jancelin/rover-gnss/Rover-RTK_ESP32/README.md

# CentipedeRTK rover-gnss

Documentation of rover-gnss

## Config ARDUINO

Ajouter le catalogue de carte ESP32 https://raw.githubusercontent.com/espressif/arduino-esp32/gh-pages/package_esp32_index.json
Configurer le chemin du répertoire en local à la racine duquel se trouve le répertoire "libraries"
File > Preference


### Probleme possible

Driver Windows => Installer le driver

Ubuntu - Ajouter le compte utilisateur au groupe serial
