jancelin/rover-gnss/conf_GNSS/UM98X/README.md

# CONFIGURATION UM980

* Avec le navigateur Chrome ou Edge ouvrir la page https://webserial.centipede.fr/index_advanced.html
* connecter en USB le ROVER
* cliquer sur *Connecter*
* Choisir le ficheir de configuration *Navx GNSS Town*
* cliquer sur *Envoyer*
