jancelin/rover-gnss/Rover-RTK_Bluetooth/DIY/pictures/feasycom-BT836_back.png

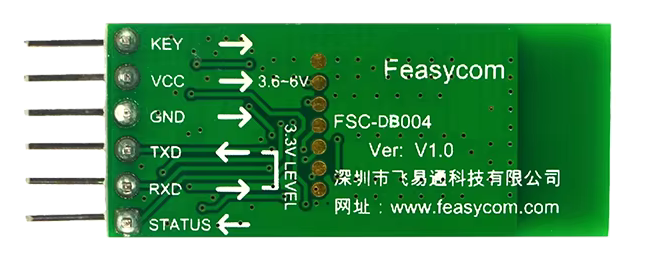
Rover-RTK_Bluetooth/DIY/pictures/feasycom-BT836_back.png
