jancelin/rover-gnss/Rover-RTK_Bluetooth/DIY/pictures/feasycom-BT836_top.png

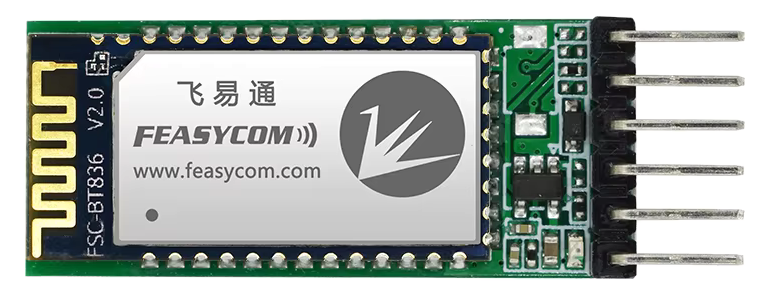
Rover-RTK_Bluetooth/DIY/pictures/feasycom-BT836_top.png
