jancelin/rover-gnss/Rover-RTK_Bluetooth/DIY/pictures/li-ion.png

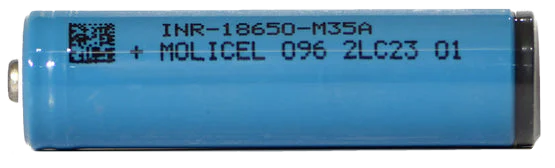
Rover-RTK_Bluetooth/DIY/pictures/li-ion.png
