jancelin/rover-gnss/Rover-RTK_Bluetooth/DIY/pictures/push_button.png

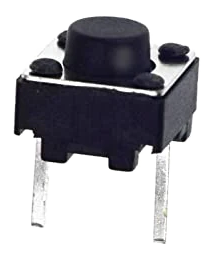
Rover-RTK_Bluetooth/DIY/pictures/push_button.png
