jancelin/rover-gnss/Rover-RTK_Bluetooth/DIY/pictures/single-battery1.png

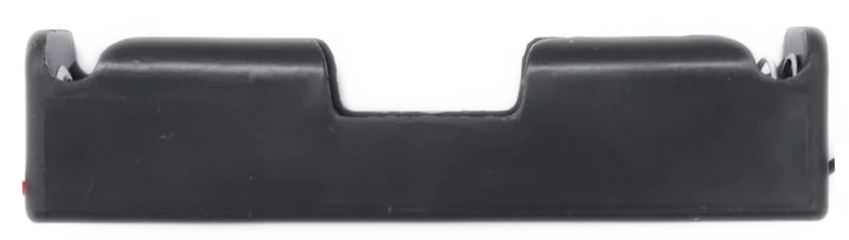
Rover-RTK_Bluetooth/DIY/pictures/single-battery1.png
