jancelin/rover-gnss/Rover-RTK_Bluetooth/DIY/pictures/um980.png

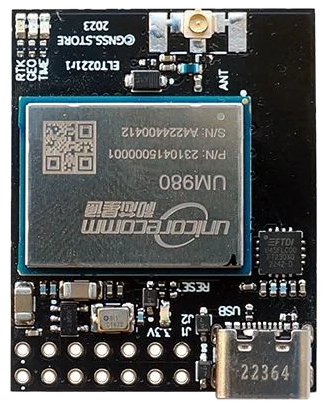
Rover-RTK_Bluetooth/DIY/pictures/um980.png
