jancelin/rover-gnss/Rover-RTK_Bluetooth/DIY/pictures/um980.webp

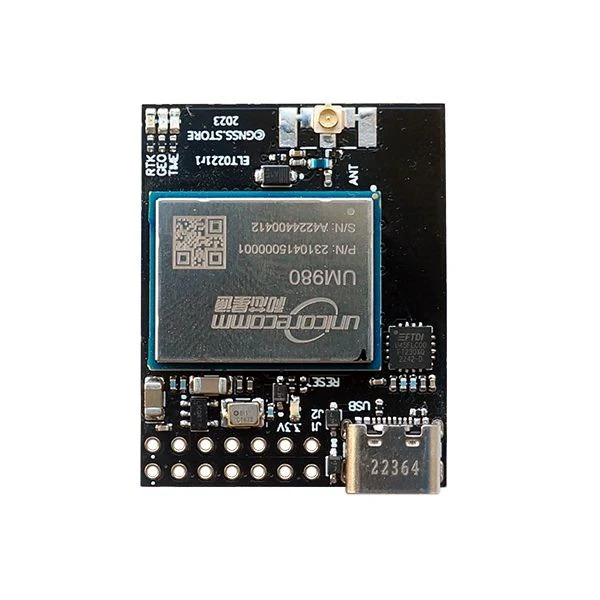
Rover-RTK_Bluetooth/DIY/pictures/um980.webp
