jancelin/rover-gnss/Rover-RTK_Bluetooth/DIY/pictures/usb_femelle.png

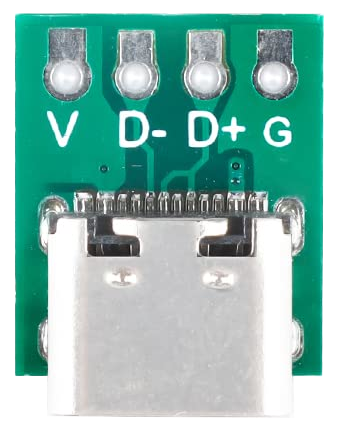
Rover-RTK_Bluetooth/DIY/pictures/usb_femelle.png
