jancelin/rover-gnss/Rover-RTK_Bluetooth/DIY/pictures/usb_male.png

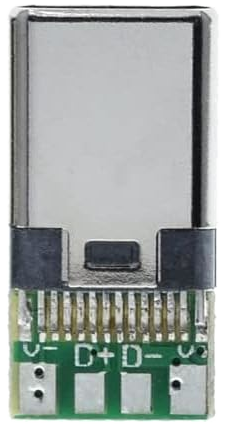
Rover-RTK_Bluetooth/DIY/pictures/usb_male.png
