jancelin/rover-gnss/Rover-RTK_ESP32/rover-rtk_BT_WIFI_NTRIP_MQTT_SENSORS/lilyGo/RTK_With_DataSensor_To_Mqtt.jpg

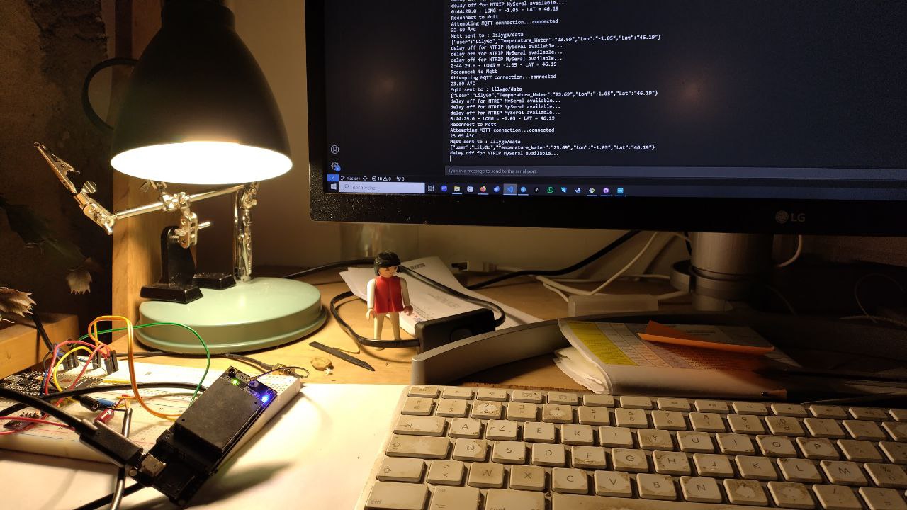
Rover-RTK_ESP32/rover-rtk_BT_WIFI_NTRIP_MQTT_SENSORS/lilyGo/RTK_With_DataSensor_To_Mqtt.jpg
