jancelin/rover-gnss/Bill_of_Materials/BOM.md

* Energie

| composant | lien | prix |
| --- | --- | --- |
| Li-ion Charge and Protection circuit 2100mA with DC-DC converter 	Li-ion Charge and Protection circuit 2100mA with DC-DC converter | https://www.tinytronics.nl/en/power/bms-and-chargers/li-ion-and-li-po/with-protection-circuit/li-ion-charge-and-protection-circuit-2100ma-with-dc-dc-converter  | 2.48€ |
| 1x 18650 Battery Holder - Leaf Spring Contacts - Wires per Cell 	1x 18650 Battery Holder - Leaf Spring Contacts - Wires per Cell | https://www.tinytronics.nl/en/power/battery-holders-and-clips/18650/1x-18650-battery-holder-leaf-spring-contacts-wires-per-cell | 1.24€ |
| Molicel 18650 Li-ion Battery - 3500mAh - 10A - INR18650-M35A 	Molicel 18650 Li-ion Battery - 3500mAh - 10A - INR18650-M35A | https://www.tinytronics.nl/en/power/batteries/18650/molicel-18650-li-ion-battery-3500mah-10a-inr18650-m35a | 4.13€ |

* Connectique

| composant | lien | prix |
| --- | --- |  --- |
| USB-C 2.0 Female to DIP Adapter 	USB-C 2.0 Female to DIP Adapter | https://www.tinytronics.nl/index.php?route=checkout/cart|0.74€ |
| USB-C 2.0 Male to Soldering Pads Adapter V2 	USB-C 2.0 Male to Soldering Pads Adapter V2 | https://www.tinytronics.nl/en/cables-and-connectors/connectors/usb/usb-c-2.0-male-to-soldering-pads-adapter-v2 | 0.41€ |
| Breadboard Tactile Pushbutton Switch Momentary 2pin 6*6*5mm 	Breadboard Tactile Pushbutton Switch Momentary 2pin 6*6*5mm | https://www.tinytronics.nl/en/switches/manual-switches/pcb-switches/breadboard-tactile-pushbutton-switch-momentary-2pin-6*6*5mm | 0.12€|
| SMA Female to IPEX-uFL Female Cable - 10cm 	SMA Female to IPEX-uFL Female Cable - 10cm | https://www.tinytronics.nl/en/cables-and-connectors/cables-and-adapters/others/sma-female-to-ufl-female-cable | 0.99€ |

* bluetooth ou ESP32

| composant | lien | prix |
| --- | --- |  --- |
| Feasycom DB004-BT836B Bluetooth 5.0 Module 	Feasycom DB004-BT836B Bluetooth 5.0 Module | https://www.tinytronics.nl/en/communication-and-signals/wireless/bluetooth/modules/feasycom-db004-bt836b-bluetooth-5.0-module | 8.26€ |
 | ESP32 | | |

* GNSS (à choisir dans la liste)

| composant | lien | prix |
| --- | --- |--- |
| mosaic-G5 RTK InCase PIN GNSS receiver board with USB C | https://gnss.store/products/elt0751?variant=55851910037836 | 329.99€ |
| UM980 RTK InCase PIN GNSS receiver board with USB C" |  https://gnss.store/products/elt0221?variant=55851791647052 | 159.99€|

* Antenne (à choisir dans la liste)

| composant | lien | prix |
| --- | --- | --- |
| AllBand+ Helix 35dB High Precision Antenna for RTK IP67 | https://gnss.store/products/elt0121 | 189.99€  |
| L1/L2/L5 High Performance Multiband RTK GNSS Active Quad Helix Antenna | https://gnss.store/products/elt0014 | 69.99€ |
| RTK GNSS Antenna BT-800S | https://store.beitian.com/products/beitian-rtk-mushroom-head-antenna-gnss-four-star-full-frequency-beidou-gps-high-precision-driving-test-bt-800s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 | 79.78€

* IMU / orientation (à choisir dans la liste)

| composant | lien | prix |
| --- | --- | --- |
| Adafruit 9-DOF Orientation IMU Fusion Breakout - BNO085 (BNO080) - STEMMA QT / Qwiic | https://learn.adafruit.com/adafruit-9-dof-orientation-imu-fusion-breakout-bno085/arduino /https://www.gotronic.fr/art-module-9-dof-bno085-ada4754-33477.htm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 | 29.90€ |
| 9-axis AHRS Tilt Inclinometer Gyroscope Module|https://www.wit-motion.com/Module/22.html- / |....|
