jancelin/rover-gnss/Rover-RTK_ESP32/unit_tests/1-ScanNetwork/README.md

Simple programme pour valider les éléments suivants sur le poste client :

- Arduino est installé correctement
- les librairies pour l'ESP32 sont bien installées
- le cable USB est opérationnel
- La détection de l'ESP32 par l'OS ( Mac, Linux, Windows ) est Ok. [Driver à installer](https://www.silabs.com/documents/public/software/CP210x_Windows_Drivers.zip)
- Compilation et push opérationel. 
- Utilisation du port console pour afficher les informations de l'ESP32
