jancelin/rover-gnss/Rover-RTK_ESP32/unit_tests/4-BME280/README

ESP32_BME280_bb)
