jancelin/rover-gnss/Rover-RTK_ESP32/unit_tests/5-WaterTemperature/Sch_ESP32_DS18B20.png

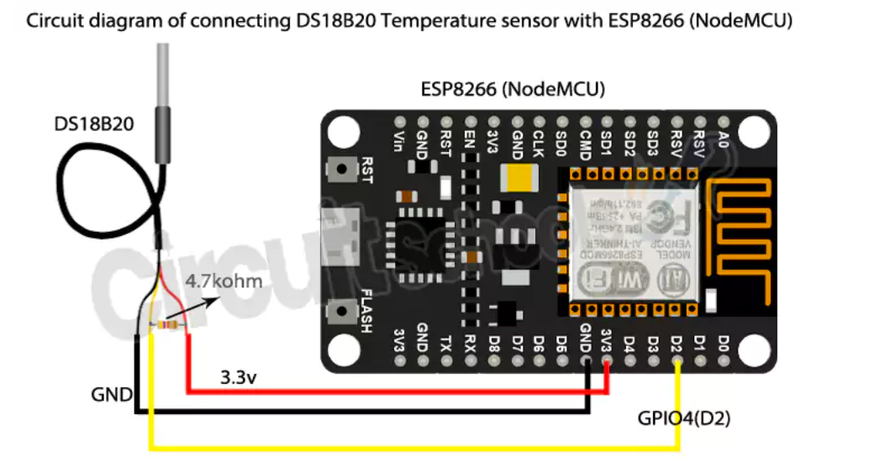
Rover-RTK_ESP32/unit_tests/5-WaterTemperature/Sch_ESP32_DS18B20.png
