jancelin/rover-gnss/Rover-RTK_Bluetooth/NavX/NavX REV1.1.pdf

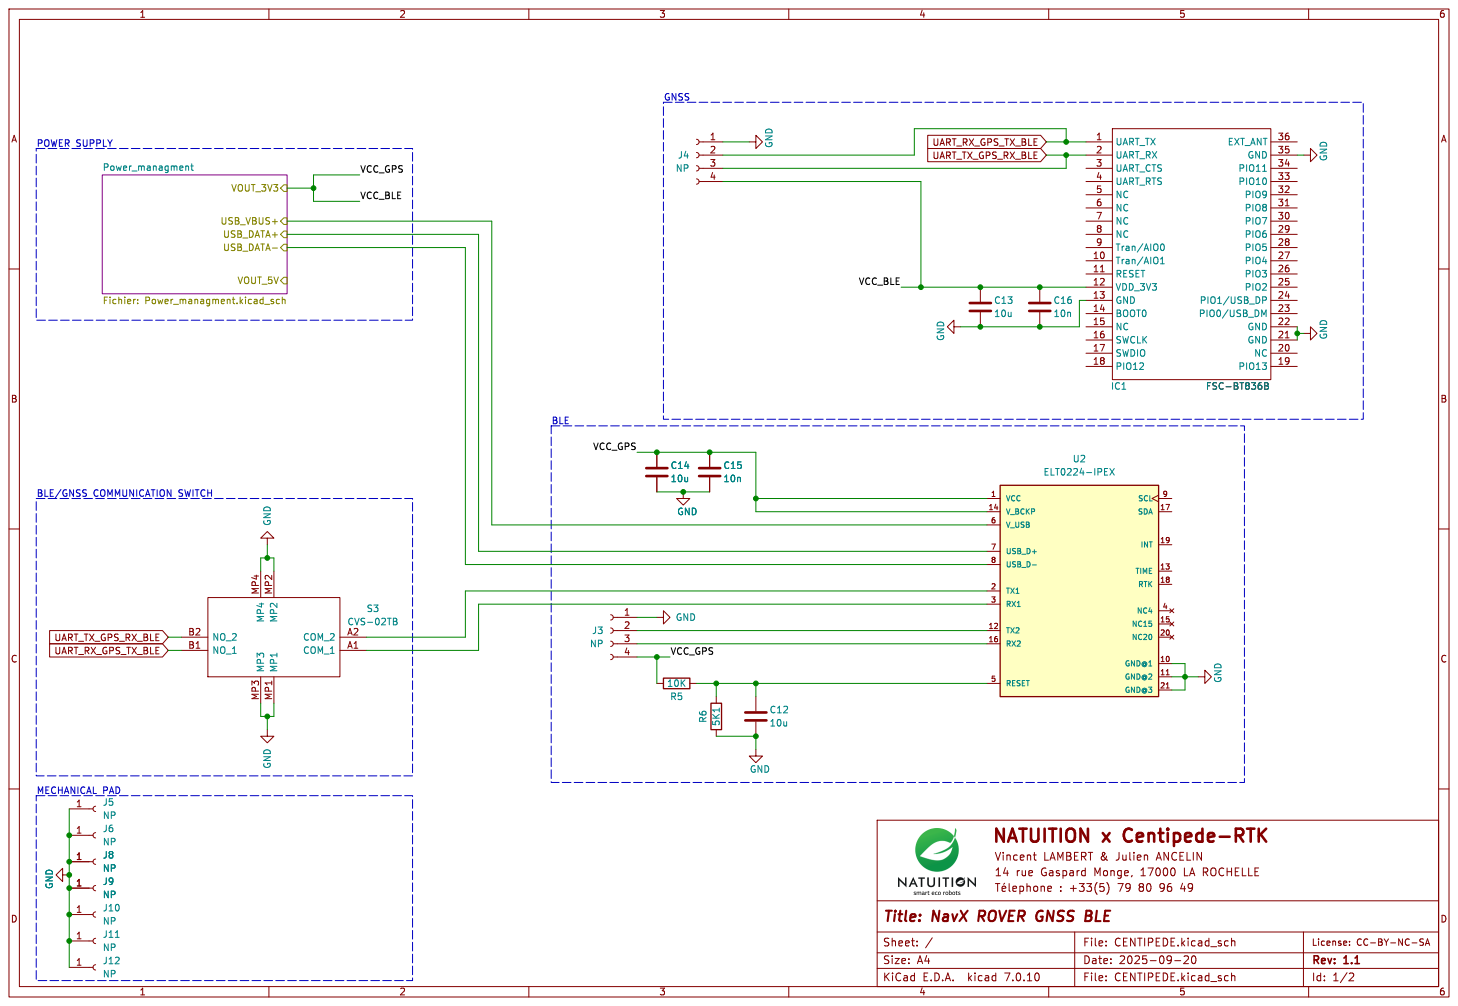
[picture p15: page 1]

BLE/GNSS COMMUNICATION SWITCH MECHANICAL PAD

NATUITION | File: CENTIPEDE.kicad_sch Sheet: / x Centipede-RTK

Id: 1/2 Title: NavX ROVER GNSS BLE

E.D.A. kicad 7.0.10 Size: A4 | | Rev: 1.1 | D Date: 2025-09-20 KiCad

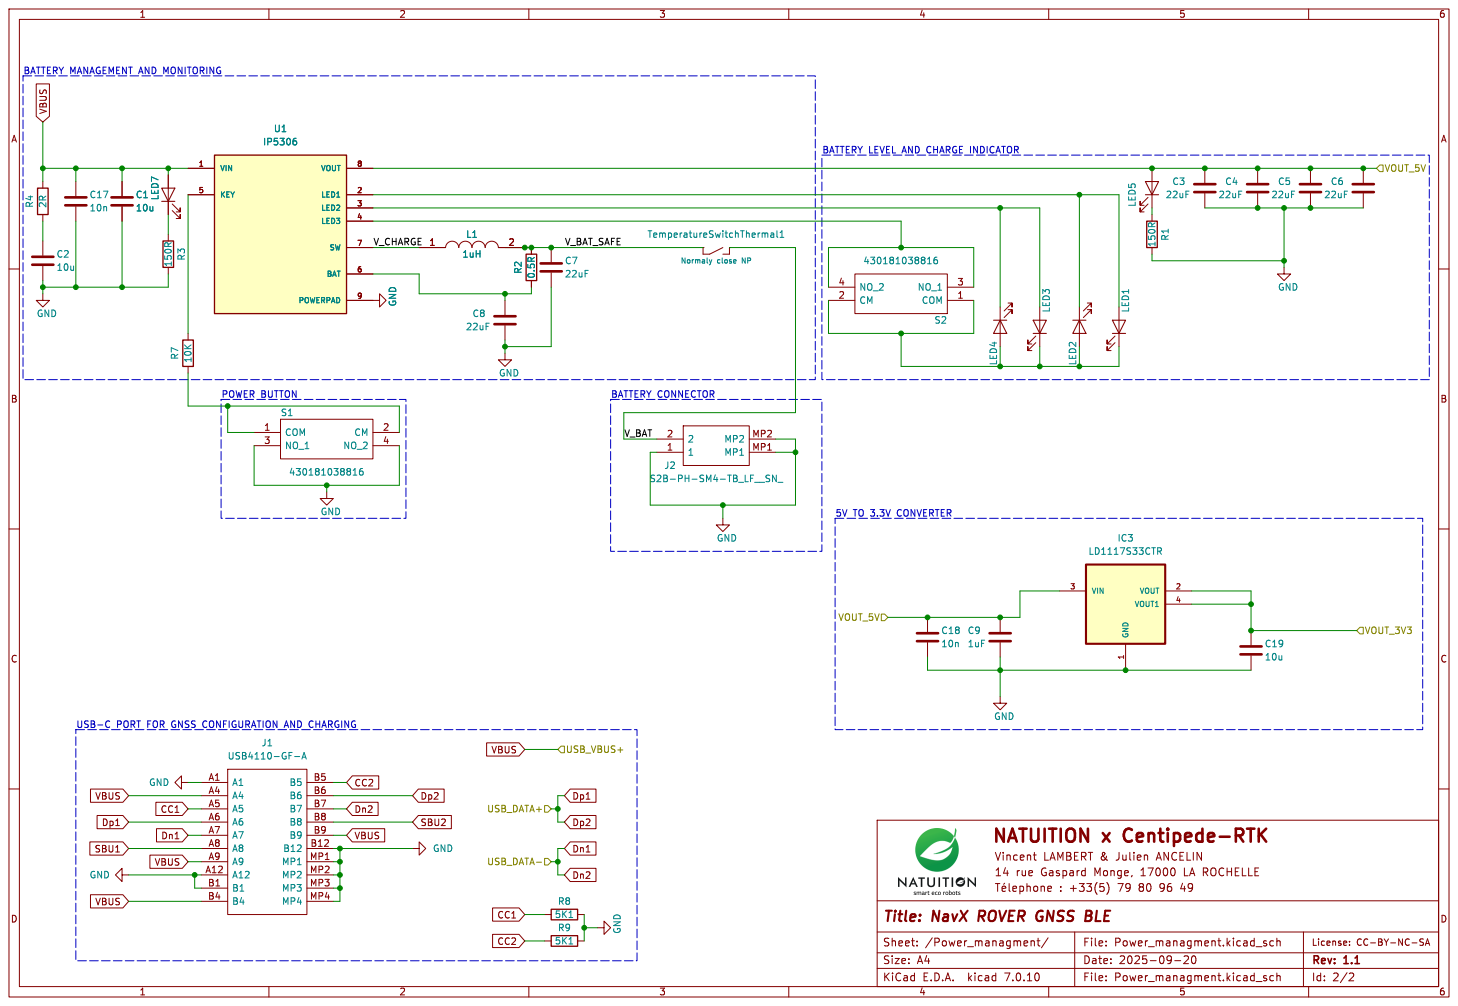
[picture p16: page 2]

BATTERY MANAGEMENT AND MONITORING

BATTERY LEVEL AND CHARGE INDICATOR
V_BAT V_BAT_SAFE

USB-C PORT FOR GNSS CONFIGURATION AND CHARGING

Id: 2/2 Title: NavX ROVER GNSS BLE
File: Power_managment.kicad_sch Sheet: /Power_managment/
