jancelin/rover-gnss/Rover-RTK_ESP32/rover-rtk_BT-SPP/Queue.h

//
// Copyright (c) 2013 Juan Palacios juan.palacios.puyana@gmail.com
// Subject to the BSD 2-Clause License
// - see < http://opensource.org/licenses/BSD-2-Clause>
//

#ifndef CONCURRENT_QUEUE_
#define CONCURRENT_QUEUE_

#include <queue>
#include <thread>
#include <mutex>
#include <condition_variable>

template <typename T> class Queue {
  public:
	T pop() {
		std::unique_lock<std::mutex> mlock(mutex_);
		while (queue_.empty()) {
			cond_.wait(mlock);
		}
		auto val = queue_.front();
		queue_.pop();
		return val;
	}

	void pop(T &item) {
		std::unique_lock<std::mutex> mlock(mutex_);
		while (queue_.empty()) {
			cond_.wait(mlock);
		}
		item = queue_.front();
		queue_.pop();
	}

	void push(const T &item) {
		std::unique_lock<std::mutex> mlock(mutex_);
		if (queue_.size() > 100) {
			log_w("BUFFER OVERFLOW");
			for (int i = 0; i < queue_.size(); i++)
				queue_.pop();
		}
		queue_.push(item);
		mlock.unlock();
		cond_.notify_one();
	}
	void push(const T *items, int len) {
		std::unique_lock<std::mutex> mlock(mutex_);
		for (int i = 0; i < len; i++) {
			if (queue_.size() > 100) {
				log_w("BUFFER OVERFLOW");
				for (int i = 0; i < queue_.size(); i++)
					queue_.pop();
			}
			queue_.push(items[i]);
		}
		mlock.unlock();
		cond_.notify_one();
	}
	bool empty() {
		std::unique_lock<std::mutex> mlock(mutex_);
		bool res = queue_.empty();
		mlock.unlock();
		return res;
	}
	Queue(int maxSize = 200) : BUF_SIZE{maxSize}, queue_{} {}; //= default;
	Queue(const Queue &) = delete;			  // disable copying
	Queue &operator=(const Queue &) = delete; // disable assignment

  private:
  	const int BUF_SIZE;
	std::queue<T> queue_;
	std::mutex mutex_;
	std::condition_variable cond_;
};

#endif
