jancelin/rover-gnss/Rover-RTK_ESP32/rover-rtk_BT_WIFI_NTRIP_MQTT_SENSORS/Connectivity.h

// Connectivity.h
#ifndef CONNECTIVITY_H
#define CONNECTIVITY_H

#include "Config.h"
#include "Logger.h"
#include <WebServer.h>

extern WebServer webServer;
void setup_wifi();
void connectToWiFi();
void reconnectMQTT();
void setup_bt();
void reconnectNTRIP();
void setupWebServer();
void handleRoot();
void handleSave();
void handleNotFound();
void checkWiFiStatus();
void switchToAPMode();
void tryReconnectWiFi();
void handleIP(); 

#endif // CONNECTIVITY_H
