jancelin/rover-gnss/Rover-RTK_ESP32/unit_tests/2-ScanI2C/2-ScanI2C.ino

#include <Wire.h>

//#include <U8x8lib.h>
// the OLED used
//U8X8_SSD1306_128X64_NONAME_SW_I2C u8x8(/* clock=*/ 15, /* data=*/ 4, /* reset=*/ 16);

void setup()
{
  Wire.begin();
 
  Serial.begin(115200);
  while (!Serial);             // Leonardo: wait for serial monitor
  Serial.println("\nI2C Scanner");

/*
  u8x8.begin();
  u8x8.setFont(u8x8_font_chroma48medium8_r);
  Serial.println("\nOled On");
  u8x8.drawString(0, 0, "SETUP - OLED On.");
*/  

delay(1000);
  
}
 
 
void loop()
{
  byte error, address;
  int nDevices;
 
  Serial.println("Scanning...");
  //u8x8.drawString(0, 1, "Scanning...");

  nDevices = 0;
  for(address = 1; address < 127; address++ )
  {
    // The i2c_scanner uses the return value of
    // the Write.endTransmisstion to see if
    // a device did acknowledge to the address.
    Wire.beginTransmission(address);
    error = Wire.endTransmission();
 
    if (error == 0)
    {

      //u8x8.drawString(0, 2, "I2C Sensor found..... : ");

      Serial.print("I2C device found at address 0x");
      if (address<16)
        Serial.print("0");
      Serial.print(address,HEX);
      Serial.println("  !");
      //u8x8.drawString(0,3, "0x" + address.c_str() );
      nDevices++;
    }
    else if (error==4)
    {
      Serial.print("Unknown error at address 0x");
      if (address<16)
        Serial.print("0");
      Serial.println(address,HEX);
    }    
  }
  if (nDevices == 0)
    Serial.println("No I2C devices found\n");
  else
    Serial.println("done\n");
 
  delay(5000);           // wait 5 seconds for next scan
}
