jancelin/rover-gnss/(commit log)

2024-06-26 Adding BME280 sensor lib
2024-06-26 reconnexion en cas de perte de Wi-Fi, MQTT ou NTRIP
2024-06-26 print to LOG_LEVEL_
2024-06-27 add BT: utilisation sur smartphone en temps que récepteurs externe #Merginmaps
2024-06-27 optimisation BT mais reste encore des saut de temps
2024-06-27 Remplacement de delay(500) et amélioration de la gestion des tâches et des sémaphores
    - Remplacé delay(500) dans la boucle principale par une gestion plus efficace des délais avec vTaskDelay pour éviter les blocages.
    - Introduction de xSemaphore pour gérer l'accès aux ressources partagées et éviter les conflits entre les tâches.
    - Création de la tâche FreeRTOS nmeaTask pour gérer les données NMEA de manière asynchrone, améliorant ainsi la réactivité du système.
    - Ajout de la fonction handleCriticalTasks pour regrouper les tâches critiques et s'assurer qu'elles sont exécutées de manière sécurisée.
    - Réduction de la fréquence d'appel de handleNTRIPData pour diminuer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
2024-06-29 commit -m "Amélioration de la régularité des publications JSON
    - Augmentation du délai d'attente pour les sémaphores dans les tâches 'publishTask' et 'nmeaTask' pour permettre une meilleure prise du sémaphore.
    - Ajustement des priorités des tâches :
    - 'nmeaTask' a maintenant une priorité plus élevée (2) pour assurer une gestion suffisante des données NMEA.
    - 'publishTask' a une priorité de 1 pour une exécution régulière.
    - Modifications pour assurer que les fonctions 'handleNTRIPData' et 'handleSerialData' sont non-bloquantes :
    - Ajout de prises et libérations de sémaphore dans 'handleNTRIPData' pour éviter les blocages.
    - Encodage des données dans 'TinyGPSPlus'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
2024-07-01 resolution bug de la perte de publication du json après reconnexion mqtt en utilisant la même variable de temp
    [lilyGo.ino]
2024-07-01 ajustement et ajout d'extra data (geoid_elev,hdop,pdop,fixmode) avec tinygpscustom. ajout des decimal des secondes
    [lilyGo.ino]
2024-07-02 Class Config avec les éléments avant le setup
2024-07-02 Class Logger les fonctions logmessage
2024-07-02 Class Connectivity regroupe les connexions wifi BT ntrip Mqtt
2024-07-02 pas de modif de code, juste du rangement dans le .ino
2024-07-02 copie du lilygo.ino avant la création de classes
2024-07-02 ajout d'une interface web pour modifier les valeurs des variables par l'utilisateur
2024-07-02 ajout d'un mode wifi AP pour accéder à l'interface web si une erreur de connection au réseau wifi est détecté + pendant wifi AP test toute les 2 min si le wifi ok
2024-07-03 correction bug sauvegarde web + ajout MDNS http://rover.local pour accéder à l'interface web
    [Connectivity.cpp, Connectivity.h, lilyGo.ino]
2024-07-03 option d'arrêt des publication MQTT par un bouton interface web
2024-07-03 ajout de rover.local/ip pour connaitre l'ip. Attention ne fonctionne pas directement sur un navigateur android (prblm dns) passer par un pc
2024-07-04 add sendgga to ntripclient but some bugs
    [3b-GNSS_RTK.ino]
2024-07-04 UPDATE - Correction d'ambiguite au niveau du logger
    [Connectivity.cpp, Logger.cpp]
2024-07-25 mv to ESP32 board, add acoustic sensor, refact web, mv 2 new directory
2024-09-18 Adding Ntrip client integrated to ESP32
2024-09-23 Ajout du secret.h et maj config PIN RX TX
2024-09-23 Debug Sourcetable message & add ntrip mount point parameter
2024-09-23 Update for ESP32
2024-09-23 Adding course & fixe type to GNSS Value
    [3a-GNSS_test.ino]
2024-09-23 Debug Ntrip working with Mqtt with Fix mode info
    [7-Wifi-MQTT-RTK.ino]
2024-09-24 add f9p config 5hz full NMEA
2024-09-24 Bug on Pin RX/TX & Adding Fix mode data from TinyGpsPlus
    [5-WaterTemperature.ino]
2024-10-02 Update Baud Rate to work with 5Hz F9P's config
2024-10-07 Update MySerial Baudrate for 5Hz
2024-10-07 upd BT
    [UM980_aog_rover_last_CONFIG.txt]
2024-10-14 Update BaudReceiver for 5Hz
2024-10-22 Add Driver link for Windows
2026-01-16 new BOM
2026-01-16 upd BOM
2026-02-09 upd rover-gnss
    [UM980_ROVER_921600bauds_5hz.cfg, UM980_aog_rover_last_CONFIG.txt]
